inequation/avr-fbus-gps/(commit log)

2012-02-02 Added Eagle schematics and a presentation about the project as documentation
    [gps.sch, quartz_vs_baud.ods]
2012-02-04 Further project development
    [gps.obj]
2012-02-04 Removed intermediates
    [gps.obj]
2012-02-04 Added proper FBus SMS frame construction
2012-02-21 Added a GPS fix status LED and support for a debug fix override button
    [gps.asm]
2012-02-22 Added scripts for programming the device with AVRdude
2012-02-26 Updated the schematics, added a board design, also the project report to documentation (in Polish)
    [gps.brd, gps.sch]
2012-02-26 First working prototype! Fixed a stack-related bug
    [gps.asm]
